DeltaGod/PER_MEA_LYINCROYAP/docs/gps_explication.pdf

# Module GPS u-blox NEO-6M

## Fonctionnement, diagnostic et correction

Projet Drone à voile

### LilyGO T-Beam V1.1 — ESP32 — Antenne Taoglas ADFGP.25A

Auteur Facundo Arito

Date 20 mai 2026

Fichier source main/src/drivers/GpsUart.cpp

Document généré automatiquement — usage interne

Drone à voile — Module GPS | Documentation technique

## 0 Contents

1 Vue d’ensemble du système GPS | 3
2 Le protocole UBX | 3
3 Pourquoi le GPS ne fonctionnait pas | 4
4 Les deux commandes UBX de correction | 5
5 Explication ligne par ligne de GpsUart::begin() | 9
6 Fonctionnement de GpsUart::update() | 12
7 Guide de diagnostic | 14

8 Chronologie de l’initialisation | 15
Conclusion | 15

## 1 Vue d’ensemble du système GPS

### 1.1 Rôle du GPS dans le drone

Le module GPS fournit au drone sa position géographique (latitude, longitude), sa vitesse sur l’eau et son cap. Ces données sont essentielles pour le pilotage automatique et pour le journal de navigation.

### 1.2 Composants matériels

Matériel impliqué

Composant | Rôle
LilyGO T-Beam V1.1 | Carte principale — intègre un ESP32, un module
| u-blox NEO-6M et un connecteur u.FL pour antenne
| externe
u-blox NEO-6M | Récepteur GPS. Communique avec l’ESP32 via UART (Serial1) et accepte des commandes de
| configuration binaires (protocole UBX)
Taoglas ADFGP.25A | Antenne active externe (patch céramique + LNA
| intégré). Le LNA nécessite une tension DC transmise
| sur le câble coaxial
Câble u.FL vers SMA | Connecte le NEO-6M à l’antenne externe

### 1.3 Flux de données

Antenne | −→ | NEO-6M | −→ | ESP32
Signal RF 1575 MHz | | Décode les satellites | | Phrases NMEA (ASCII)

Le NEO-6M reçoit les signaux radio des satellites, calcule la position et émet des phrases NMEA sur son UART. L’ESP32 lit ce flux via Serial1 et utilise la biblio-thèque TinyGPSPlus pour en extraire les données utiles.

## 2 Le protocole UBX

### 2.1 Deux langages sur un même fil

Le NEO-6M supporte deux protocoles sur son UART :

- NMEA — phrases textuelles (ex. $GPGGA,...) lues pour extraire la position. C’est le flux normal en fonctionnement.
- UBX — protocole binaire propriétaire u-blox, utilisé pour configurer le module (activer des fonctions, modifier des paramètres, sauvegarder en mémoire).

Le NEO-6M distingue une trame UBX d’une phrase NMEA grâce aux deux premiers octets : 0xB5 62 pour UBX, le caractère $ pour NMEA.

### 2.2 Structure d’une trame UBX

Sync 1 | Sync 2 | Classe | ID | Longueur
(LE)

Payload

0xB5 | 0x62 | 1 octet | 1 octet | 2 octets | N octets

Chaque trame se termine par un checksum de Fletcher sur 2 octets (CK_A, CK_B), calculé sur tous les octets depuis la classe jusqu’à la fin du payload (les deux octets de synchronisation sont exclus).

### 2.3 Calcul du checksum de Fletcher

1 | u i nt8_t CK_ A = 0 , CK_B = 0;
2 | // Parcourir : classe + ID + longueur (2 octets) + payload
3 | f o r ( i nt i = 0; i < N ; i ++) {
4 | CK_ A += d a t a [ i ];
5 | CK_B += CK_ A ;
6 | }
7 | // CK_ A et CK_B sont appended a la fin de la trame

Ce checksum garantit l’intégrité de la trame : si un bit est corrompu, le NEO-6M ignore la commande.

## 3 Pourquoi le GPS ne fonctionnait pas

### 3.1 Symptôme observé

Le compteur chars de TinyGPSPlus restait figé à 10 malgré le GPS alimenté et l’antenne connectée.

Diagnostic : que signifie chars = 10 ?

chars comptabilise chaque octet reçu sur Serial1. Une trame UBX ACK-ACK (réponse d’acquittement du NEO-6M) fait exactement 10 octets :

B5 62 05 01 02 00 06 09 17 6B
B5 62 Sync UBX
05 01 Classe ACK, ID ACK
02 00 Longueur payload = 2
06 09 Écho de la commande acquittée (classe CFG, ID CFG)

17 6B Checksum

Conclusion : le GPS était bien alimenté et fonctionnel, il répondait aux commandes UBX, mais n’émettait aucune phrase NMEA.

### 3.2 Cause racine : la mémoire flash interne du NEO-6M

Le NEO-6M possède une mémoire flash interne qui persiste la configuration entre les mises sous tension. Une session de configuration antérieure (via le logiciel u-center de u-blox) avait sauvegardé une configuration qui désactivait toutes les phrases NMEA.

Cause identifiée

La configuration persistante en flash désactivait la sortie NMEA sur le port UART du NEO-6M. Le module fonctionnait normalement mais n’émettait que des réponses UBX, invisibles pour TinyGPSPlus.

### 3.3 Cause aggravante : antenne active sans alimentation DC

L’antenne Taoglas ADFGP.25A est une antenne active : elle contient un amplificateur LNA qui nécessite une tension DC transmise sur le câble coaxial. Par défaut après une réinitialisation ROM, le superviseur d’antenne du NEO-6M est désactivé :

- Aucune tension DC sur le connecteur u.FL ⇒ LNA hors tension.
- Le commutateur RF du T-Beam pointe vers le patch céramique interne au lieu de l’antenne externe.
- Résultat : zéro signal GPS même avec l’antenne externe branchée.

## 4 Les deux commandes UBX de correction

### 4.1 Commande 1 — CFG-CFG : réinitialisation usine

### 4.1.1 Objectif

Effacer la configuration sauvegardée en flash et recharger les paramètres d’usine depuis la ROM interne. Après cette commande :

- Le UART1 du NEO-6M repasse à 9 600 bauds.
- Toutes les phrases NMEA standard sont réactivées.
- Le superviseur d’antenne est désactivé (état ROM par défaut).

### 4.1.2 Structure de la trame

Sync | Classe | ID | Longueur | Payload | CRC
0xB5 62 | 0x06 | 0x09 | 0x0D 00 | 13 octets | 0x71 FE

Classe 0x06 = CFG (configuration), ID 0x09 = sous-commande de gestion de la configuration persistante.

### 4.1.3 Décomposition du payload (13 octets, little-endian)

Champ (32 bits
LE)
Valeur hex | Signification
clearMask | 0x0000001F | Efface 5 sections de configuration
saveMask | 0x00000000 | Ne sauvegarde rien
loadMask | 0x0000001F | Recharge depuis la ROM
deviceMask | 0x17 (8 bits) | Cible : BBR + Flash + EEPROM

Pourquoi clearMask

Ce champ est un masque de bits : chaque bit correspond à une section de la configuration persistante.

Bit | Valeur hex | Section effacée
0 | 0x01 | ioPort — configuration des ports (UART,
| | SPI, USB)
1 | 0x02 | msgConf — activation des phrases
| | NMEA/UBX par port
2 | 0x04 | infMsg — messages d’information
3 | 0x08 | navConf — paramètres de navigation (mode,
| | SBAS)
4 | 0x10 | rxmConf — mode récepteur
0x01 | 0x02 | 0x04 | 0x08 | 0x10 = 0x1F

La section msgConf (bit 1) est la plus critique : c’est elle qui désactivait les phrases NMEA dans notre cas.

### 4.1.4 Code source et explication octet par octet

1 | st a t i c c o nst u i nt8_t kCfgCfgR e s e t [] = {
2 | 0 xB5 , 0 x62 , | // Sync UBX -- debut obligato

ire de toute trame

3 | 0 x06 , 0 x09 , | // Classe CFG (0 x06 ), ID CFG

(0 x09 )

4 | 0 x0D , 0 x00 , | // Longueur payload : 13 octe

ts (littl e-endian)

5 | 0 x1F , 0 x00 , 0 x00 , 0 x00 , // clearMask : efface 5 sectio

ns de config

6 | 0 x00 , 0 x00 , 0 x00 , 0 x00 , // saveMask | : ne sauvegarde r

ien

7 | 0 x1F , 0 x00 , 0 x00 , 0 x00 , // loadMask | : recharge depuis

la ROM

8 | 0 x17 , | // deviceMask : BBR (1) +Flash
(2) +EEPROM(4)+SPI (16)
9 | 0 x71 , 0 xF E | // Checks um Fletch er (CK_ A=0

x71 , CK_B =0 xFE)

10 };

Pourquoi static const ?

static dans une fonction signifie que le tableau est alloué une seule fois en mémoire flash (section .rodata), et non sur la pile à chaque appel. Sur un microcontrôleur avec peu de RAM comme l’ESP32, c’est une bonne pratique pour les constantes volumineuses.

### 4.2 Commande 2 — CFG-ANT : activation de l’antenne active

### 4.2.1 Objectif

Activer le superviseur d’antenne du NEO-6M, qui accomplit trois actions :

1. Fournit une tension DC sur le câble coaxial pour alimenter le LNA de l’antenne Taoglas.
2. Commande le commutateur RF du T-Beam (via la broche ANT_FLAG du NEO-6M) pour sélectionner l’antenne externe u.FL.
3. Active la détection de court-circuit pour protéger le module.

### 4.2.2 Structure de la trame

Sync | Classe | ID | Longueur | Payload | CRC
0xB5 62 | 0x06 | 0x13 | 0x04 00 | 4 octets | 0x47
| | | | | 57

Classe 0x06 = CFG, ID 0x13 = ANT (configuration de l’antenne).

### 4.2.3 Décomposition du payload

Champ
(16 bits)
Valeur | Signification
flags | 0x001B | Voir tableau ci-dessous
pins | 0x000F | Mapping broches — valeur par défaut
| | NEO-6M

Décomposition de flags = 0x001B

Bit | Nom | Fonction
0 | svcs | Alimentation DC + commutateur RF vers
| | antenne externe
1 | scd | Détection de court-circuit
3 | pdwnOnSCD | Coupe l’alimentation si court-circuit détecté
4 | recovery | Rétablissement automatique après court-circuit
0x01 | 0x02 | 0x08 | 0x10 = 0x1B

### 4.2.4 Code source

1 | st a t i c c o nst u i nt8_t kCfg A nt [] = {
2 | 0 xB5 , 0 x62 , | // Sync UBX
3 | 0 x06 , 0 x13 , | // Classe CFG (0 x06 ), ID ANT (0 x13 )
4 | 0 x04 , 0 x00 , | // Longueur payload : 4 octets
5 | 0 x1B , 0 x00 , | // flags (LE) : svcs + scd + pdwn O nSCD +

recovery

6 | 0 x0F , 0 x00 , | // pins | (LE) : mapping broches par defa
| ut NEO -6M
7 | 0 x47 , 0 x57 | // Checks um Fletch er
8 | };

## 5 Explication ligne par ligne de GpsUart::begin()

Voici le code complet de la fonction, suivi d’une explication détaillée de chaque bloc.

1 | v o i d Gps U a rt :: b e g i n () {
2 | gsvT o t a l_ . b e g i n ( gps_ , " GPGSV ", 3) ;
3 | S e r i a l1 . b e g i n ( B o a rdC o nf i g :: GPS_B A U D_R A T E , S E R I A L_8N1 ,
4 | B o a rdC o nf i g :: GPS_RX_P IN , B o a rdC o nf i g ::
| GPS_TX_P I N ) ;
5 | DBG ("GPS", "Serial1 started %u baud RX=GPIO%d TX=GPIO%
| d",
6 | ( u ns i gn e d ) B o a rdC o nf i g :: GPS_B A U D_R A T E ,
7 | B o a rdC o nf i g :: GPS_RX_P IN , B o a rdC o nf i g :: GPS_TX_P I N ) ;

8

9 | d e l a y (500) ; | // attendr e fin du boot interne du NEO -6

M

10
11 | st a t i c c o nst u i nt8_t kCfgCfgR e s e t [] = {
12 | 0 xB5 , 0 x62 , 0 x06 , 0 x09 , 0 x0D , 0 x00 ,
13 | 0 x1F , 0 x00 , 0 x00 , 0 x00 ,
14 | 0 x00 , 0 x00 , 0 x00 , 0 x00 ,
15 | 0 x1F , 0 x00 , 0 x00 , 0 x00 ,
16 | 0 x17 ,
17 | 0 x71 , 0 xF E
18 | };
19 | S e r i a l1 . wr i t e ( kCfgCfgR e s et , s i z e o f ( kCfgCfgR e s e t ) ) ;
20 | DBG ("GPS", "CFG -CFG sent -- factory reset to ROM defau
| lts ") ;
21 | d e l a y (1500) ; | // attendr e redemarrage apres reinitiali
| sation

22
23 | wh i l e ( S e r i a l1 . a v a i l a bl e () ) S e r i a l1 . r e a d () ; | // vider
| le buffer

24
25 | st a t i c c o nst u i nt8_t kCfg A nt [] = {
26 | 0 xB5 , 0 x62 , 0 x06 , 0 x13 , 0 x04 , 0 x00 ,
27 | 0 x1B , 0 x00 ,
28 | 0 x0F , 0 x00 ,
29 | 0 x47 , 0 x57
30 | };
31 | S e r i a l1 . wr i t e ( kCfg A nt , s i z e o f ( kCfg A nt ) ) ;
32 | d e l a y (100) ;
33 | DBG ("GPS", "CFG -ANT sent -- active antenna supervisor
| + bias enabled") ;
34 | }

### 5.1 Bloc 1 — Initialisation du parser NMEA personnalisé

1 gsvT o t a l_ . b e g i n ( gps_ , " GPGSV ", 3) ;

TinyGPSPlus ne décode pas toutes les phrases NMEA automatiquement. La phrase GPGSV (satellites en vue) n’est pas traitée par défaut : il faut déclarer explicitement quel champ extraire.

gsvTotal_ est un objet TinyGPSCustom. Cette ligne lui dit : dans les phrases GPGSV, extraire le champ numéro 3 (le nombre total de satellites en vue). Ce champ devient

lisible via gsvTotal_.value().

### 5.2 Bloc 2 — Ouverture du port série

1 | S e r i a l1 . b e g i n ( B o a rdC o nf i g :: GPS_B A U D_R A T E , S E R I A L_8N1 ,
2 | B o a rdC o nf i g :: GPS_RX_P IN , B o a rdC o nf i g :: GPS_TX_P I N ) ;

Configure le port UART1 de l’ESP32 pour communiquer avec le NEO-6M :

- GPS_BAUD_RATE = 9 600 bauds — vitesse par défaut ROM du NEO-6M.
- SERIAL_8N1 — 8 bits de données, pas de parité, 1 bit de stop.
- Les broches GPIO sont définies dans BoardConfig.h et correspondent au câblage du T-Beam.

### 5.3 Bloc 3 — Attente de démarrage du GPS

1 d e l a y (500) ;

Le NEO-6M a besoin d’environ 100 à 400 ms pour terminer sa séquence de mise sous tension. Sans ce délai, les commandes UBX envoyées immédiatement pourraient être ignorées. On attend 500 ms pour une marge confortable.

### 5.4 Bloc 4 — Envoi de CFG-CFG

1 S e r i a l1 . wr i t e ( kCfgCfgR e s et , s i z e o f ( kCfgCfgR e s e t ) ) ;

Envoie les 21 octets de la trame CFG-CFG sur le UART. sizeof() est évalué par le compilateur : sa valeur est exacte et ne peut pas être oubliée ou erronée.

Le NEO-6M reçoit la trame, vérifie le checksum, puis :

1. Efface les sections spécifiées en flash et BBR.
2. Recharge ces sections depuis sa ROM (paramètres d’usine).
3. Envoie une trame ACK-ACK de confirmation.

4. Redémarre son moteur de navigation interne.

### 5.5 Bloc 5 — Attente du redémarrage

1 d e l a y (1500) ;

La réinitialisation ROM prend entre 500 ms et 1 200 ms. On attend 1 500 ms pour s’assurer que le module est de nouveau prêt avant d’envoyer CFG-ANT.

### 5.6 Bloc 6 — Vidage du buffer

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

Pendant le délai de 1 500 ms, le GPS a pu envoyer des données sur le UART (ACK-ACK, premières phrases NMEA de démarrage). Ces données s’accumulent dans le buffer de l’ESP32. On les lit et on les jette pour repartir sur une base propre avant CFG-ANT.

### 5.7 Bloc 7 — Envoi de CFG-ANT

1 | S e r i a l1 . wr i t e ( kCfg A nt , s i z e o f ( kCfg A nt ) ) ;
2 | d e l a y (100) ;

Envoie les 12 octets de la trame CFG-ANT. Le NEO-6M l’applique immédiatement :

1. Alimentation DC activée sur u.FL ⇒ LNA Taoglas alimenté.
2. Commutateur RF du T-Beam basculé vers l’antenne externe.
3. Détection de court-circuit activée.

Le delay(100) laisse le temps au module d’appliquer la configuration et de renvoyer l’ACK avant la fin de la fonction.

## 6 Fonctionnement de GpsUart::update()

La fonction update() est appelée à chaque cycle de la boucle principale (environ 50 fois par seconde). Elle lit les octets disponibles sur le UART et les passe au parser

TinyGPSPlus.

1 | v o i d Gps U a rt :: u pd a t e () {
2 | wh i l e ( S e r i a l1 . a v a i l a bl e () ) {
3 | ch a r c = S e r i a l1 . r e a d () ;
4 | gps_ . e nc o d e ( c ) ; | // (1) passe l’octet
| au parser

5
6 | i f ( c == ’\n’) { | // (2) fin de phr ase

NMEA

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

;

9 | l i n e L e n_ = 0;
10 | } e ls e i f ( c != ’\r’ && l i n e L e n_ < s i z e o f ( l i n e B u f_
) - 1) {
11 | l i n e B u f_ [ l i n e L e n_ ++] = c ; // (3) açumule les c
| aracteres
12 | }
13 | }

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

16
17 | i f ( n o wV a l i d && ! pr e vV a l i d_ ) { DBG (" GPS", "FIX ACQUIRE
| D ...") ; }
18 | i f (! n o wV a l i d && pr e vV a l i d_ ) { DBG (" GPS", "FIX LOST") ;
}
19 | pr e vV a l i d_ = n o wV a l i d ;

20
21 | p o s_ . v a l i d | = n o wV a l i d ; | // (5) mise a jour

str ucture publique

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

0.0;

23 | p o s_ . l o n | = n o wV a l i d ? gps_ . l o c a t i o n . lng () | :

0.0;

24 | p o s_ . sp e e dKmph | = gps_ . sp e e d . i sV a l i d ()
25 | ? ( fl o a t ) gps_ . sp e e d . kmph () | : 0.0 f

;

26 | p o s_ . c o u rs e D e g | = gps_ . c o u rs e . i sV a l i d ()
27 | ? ( fl o a t ) gps_ . c o u rs e . d e g () | : 0.0 f

;

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

: 0;

30 | p o s_ . hd o p | = gps_ . hd o p . i sV a l i d ()
31 | ? ( fl o a t ) gps_ . hd o p . hd o p () | : 99.9

f ;

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

U L ;

34 }

1. gps_.encode(c) — Le cœur du parser. TinyGPSPlus reçoit un octet à la fois et reconstruit les phrases NMEA en interne. Quand une phrase complète et valide est reçue, il met à jour ses champs internes (location, speed, satellites, etc.).
2. Capture de la phrase complète — Quand le caractère \n (fin de ligne NMEA) est reçu, on copie le buffer dans completedLine_ pour permettre l’affichage de la dernière phrase NMEA lors du diagnostic.
3. Accumulation caractère par caractère — Les caractères sont accumulés dans lineBuf_. Le \r (retour chariot) est ignoré : le protocole NMEA utilise CR+LF comme fin de ligne, mais seul LF délimite la phrase.
4. gps_.location.isValid() — Retourne true uniquement si une phrase NMEA valide avec fix actif a été reçue récemment. Un fix froid (premier démarrage) prend typiquement 30 secondes à 2 minutes à l’extérieur avec une bonne vue du ciel.
5. Mise à jour de pos_ — La structure publique est rafraîchie à chaque appel. Un champ invalide retourne une valeur de sécurité : 0.0 pour les coordonnées, 99.9 pour HDOP (valeur maximale = pas de fix), 0xFFFFFFFF pour l’âge (signifiant donnée absente).

## 7 Guide de diagnostic

Symptôme | Cause probable | Action
chars figé à 0 | UART mal câblé, broches TX/RX échangées, ou GPS non alimenté | Vérifier câblage et alimentation

Symptôme | Cause probable | Action
chars figé à 10 | Config flash corrompue — NMEA désactivé | Déjà corrigé dans begin() par CFG-CFG
chars monte, visible = 0 | Obstruction physique (toit, bâtiment) | Aller à l’extérieur, ciel dégagé
chars monte, visible > 0, pas de fix | Temps d’acquisition froid normal | Attendre 1 à 3 min à l’extérieur
chars monte, visible = 0 même dehors | LNA non alimenté ou mauvais connecteur | Vérifier CFG-ANT, câble u.FL et sertissage
Fix acquis puis perdu régulièrement | HDOP élevé, obstruction partielle | Dégager la vue du ciel (mât, pont)

## 8 Chronologie de l’initialisation

Temps (ms) Événement

0 | Serial1.begin() — UART ESP32 ouvert à 9 600 bauds
0 – 500 | Délai de démarrage — le NEO-6M termine son boot interne
500 | Envoi de CFG-CFG — demande de réinitialisation ROM
≈ 501 | Le NEO-6M répond ACK-ACK (10 octets)
501 – 2000 | Délai de redémarrage — rechargement de la config ROM
2000 | Vidage du buffer UART
2000 | Envoi de CFG-ANT — activation du superviseur d’antenne
≈ 2100 | Fin de begin() — le GPS est prêt à émettre du NMEA
2100+ | update() appelé en boucle — décodage des phrases NMEA
≈ 60 000 – 180 000 | Premier fix GPS (typique en extérieur, ciel dégagé)

## 8 Conclusion

Le dysfonctionnement du GPS était dû à la persistance d’une configuration corrompue dans la mémoire flash interne du NEO-6M, qui avait désactivé toutes les sorties NMEA. La correction consiste à envoyer systématiquement, à chaque démarrage, une commande de réinitialisation usine (CFG-CFG) suivie de l’activation du superviseur d’antenne active (CFG-ANT).

Ces deux commandes sont intégrées dans GpsUart::begin(), ce qui garantit un comportement correct indépendamment de toute session de configuration antérieure effectuée avec u-center ou tout autre outil.

État actuel du système

✓ Phrases NMEA réactivées systématiquement à chaque boot. ✓ Antenne active Taoglas ADFGP.25A alimentée correctement. ✓ Commutateur RF T-Beam basculé vers l’antenne externe. ✓ Fix GPS confirmé lors des tests en extérieur.
