DeltaGod/PER_MEA_LYINCROYAP/main/src/navigation/navigation.h

/**
 * Logique de navigation partagee entre le firmware Arduino et la simulation.
 */

#ifndef NAVIGATION_H
#define NAVIGATION_H

#include <cmath>

#ifndef M_PI
#define M_PI 3.14159265358979323846
#endif

static const double NAV_DIRECT_DEAD_ZONE_DEG = 5.0;
static const double NAV_VDB_RUDDER_GAIN = 0.8;
static const double NAV_DIRECT_RUDDER_GAIN = 0.5;
static const float NAV_RUDDER_CORRECTION_LIMIT_DEG = 20.0f;
static const float NAV_RUDDER_COMMAND_LIMIT_DEG = 110.0f;
static const double NAV_DEFAULT_CORRIDOR_HALF_WIDTH_M = 100.0;
static const double NAV_GEO_EPSILON_DEG = 0.0000001;
static const double NAV_EARTH_RADIUS_M = 6371000.0;
static const double NAV_UPWIND_FORBIDDEN_ANGLE_DEG = 45.0;
static const double NAV_DOWNWIND_FORBIDDEN_ANGLE_DEG = 20.0;
static const double NAV_RUDDER_STEP_DEG = 5.0;
static const double NAV_SAIL_RIGHT_DEG = 10.0;
static const double NAV_SAIL_LEFT_DEG = -10.0;

inline double nav_relativeAngle(double referenceDeg, double targetDeg) {
  double relativeDeg = targetDeg - referenceDeg;
  if (relativeDeg > 180)
    relativeDeg -= 360;
  else if (relativeDeg < -180)
    relativeDeg += 360;
  return relativeDeg;
}

inline bool nav_sameSign(double a, double b) {
  return (a >= 0 && b >= 0) || (a < 0 && b < 0);
}

inline double nav_oppositeAngle(double angleDeg) {
  double oppositeDeg = angleDeg + 180;
  return (oppositeDeg >= 360) ? oppositeDeg - 360 : oppositeDeg;
}

inline int nav_angleSide(double angleDeg) { return angleDeg < 0 ? -1 : 1; }

inline float nav_clampRudder(float rudderAngleDeg) {
  if (rudderAngleDeg > NAV_RUDDER_CORRECTION_LIMIT_DEG)
    return NAV_RUDDER_CORRECTION_LIMIT_DEG;
  if (rudderAngleDeg < -NAV_RUDDER_CORRECTION_LIMIT_DEG)
    return -NAV_RUDDER_CORRECTION_LIMIT_DEG;
  return rudderAngleDeg;
}

inline float nav_rudderCompensation(double relativeWindDeg) {
  return static_cast<float>(relativeWindDeg / 2.0);
}

inline float nav_rudderCorrection(float servoCommandDeg,
                                  double relativeWindDeg) {
  return nav_clampRudder(servoCommandDeg -
                         nav_rudderCompensation(relativeWindDeg));
}

inline float nav_rudderCommand(float correctionDeg, double relativeWindDeg) {
  float commandDeg =
      nav_rudderCompensation(relativeWindDeg) + nav_clampRudder(correctionDeg);
  if (commandDeg > NAV_RUDDER_COMMAND_LIMIT_DEG)
    return NAV_RUDDER_COMMAND_LIMIT_DEG;
  if (commandDeg < -NAV_RUDDER_COMMAND_LIMIT_DEG)
    return -NAV_RUDDER_COMMAND_LIMIT_DEG;
  return commandDeg;
}

inline double nav_normalizeAngle(double angleDeg) {
  while (angleDeg >= 360)
    angleDeg -= 360;
  while (angleDeg < 0)
    angleDeg += 360;
  return angleDeg;
}

inline bool nav_isBetweenOnShortestTurn(double angleDeg, double startDeg,
                                        double endDeg) {
  double turnDeg = nav_relativeAngle(startDeg, endDeg);
  double angleFromStartDeg = nav_relativeAngle(startDeg, angleDeg);
  if (turnDeg >= 0)
    return angleFromStartDeg > 0 && angleFromStartDeg < turnDeg;
  return angleFromStartDeg < 0 && angleFromStartDeg > turnDeg;
}

inline void nav_gpsDeltaMeters(double refLatDeg, double refLngDeg,
                               double latDeg, double lngDeg, double &eastM,
                               double &northM) {
  double latRad = refLatDeg * M_PI / 180.0;
  northM = (latDeg - refLatDeg) * NAV_EARTH_RADIUS_M * M_PI / 180.0;
  eastM = (lngDeg - refLngDeg) * NAV_EARTH_RADIUS_M * std::cos(latRad) * M_PI /
          180.0;
}

inline double nav_crossTrackErrorMeters(double startLatDeg, double startLngDeg,
                                        double endLatDeg, double endLngDeg,
                                        double boatLatDeg, double boatLngDeg) {
  double pathEastM, pathNorthM, boatEastM, boatNorthM;
  nav_gpsDeltaMeters(startLatDeg, startLngDeg, endLatDeg, endLngDeg, pathEastM,
                     pathNorthM);
  nav_gpsDeltaMeters(startLatDeg, startLngDeg, boatLatDeg, boatLngDeg,
                     boatEastM, boatNorthM);

  double pathLengthM =
      std::sqrt(pathEastM * pathEastM + pathNorthM * pathNorthM);
  if (pathLengthM < 0.1)
    return 0.0;

  return (pathNorthM * boatEastM - pathEastM * boatNorthM) / pathLengthM;
}

inline bool nav_hasPassedWaypoint(double startLatDeg, double startLngDeg,
                                  double endLatDeg, double endLngDeg,
                                  double boatLatDeg, double boatLngDeg) {
  double pathEastM, pathNorthM, boatEastM, boatNorthM;
  nav_gpsDeltaMeters(startLatDeg, startLngDeg, endLatDeg, endLngDeg, pathEastM,
                     pathNorthM);
  nav_gpsDeltaMeters(startLatDeg, startLngDeg, boatLatDeg, boatLngDeg,
                     boatEastM, boatNorthM);

  double pathLengthSquared =
      pathEastM * pathEastM + pathNorthM * pathNorthM;
  if (pathLengthSquared < 0.01)
    return false;

  return boatEastM * pathEastM + boatNorthM * pathNorthM >=
         pathLengthSquared;
}

inline int nav_sideMovingTowardCrossTrack(double startLatDeg,
                                          double startLngDeg, double endLatDeg,
                                          double endLngDeg, double axisDeg,
                                          double safeAngleDeg,
                                          int desiredCrossTrackSign,
                                          int fallbackSide) {
  double pathEastM, pathNorthM;
  nav_gpsDeltaMeters(startLatDeg, startLngDeg, endLatDeg, endLngDeg, pathEastM,
                     pathNorthM);
  double pathLengthM =
      std::sqrt(pathEastM * pathEastM + pathNorthM * pathNorthM);
  if (pathLengthM < 0.1)
    return fallbackSide;

  double pathEastUnit = pathEastM / pathLengthM;
  double pathNorthUnit = pathNorthM / pathLengthM;
  int bestSide = fallbackSide;
  double bestScore = -1.0;

  for (int side = -1; side <= 1; side += 2) {
    double headingRad = nav_normalizeAngle(axisDeg + side * safeAngleDeg) *
                        M_PI / 180.0;
    double crossVelocity =
        pathNorthUnit * std::sin(headingRad) -
        pathEastUnit * std::cos(headingRad);

    if ((desiredCrossTrackSign > 0 && crossVelocity > 0) ||
        (desiredCrossTrackSign < 0 && crossVelocity < 0)) {
      double score = std::abs(crossVelocity);
      if (score > bestScore) {
        bestScore = score;
        bestSide = side;
      }
    }
  }

  return bestSide;
}

inline int nav_sideMovingTowardWaypoint(double axisDeg, double safeAngleDeg,
                                        double waypointHeadingDeg,
                                        int fallbackSide) {
  int bestSide = fallbackSide;
  double bestProgress = -2.0;
  double waypointHeadingRad = waypointHeadingDeg * M_PI / 180.0;

  for (int side = -1; side <= 1; side += 2) {
    double headingRad = nav_normalizeAngle(axisDeg + side * safeAngleDeg) *
                        M_PI / 180.0;
    double progress =
        std::sin(headingRad) * std::sin(waypointHeadingRad) +
        std::cos(headingRad) * std::cos(waypointHeadingRad);
    if (progress > bestProgress) {
      bestProgress = progress;
      bestSide = side;
    }
  }

  return bestSide;
}

struct NavResult {
  float sailAngle;
  float rudderAngle;
  int sendInterval;
  const char *mode;
  const char *logMessage;
  bool windAcquired;
  double acquiredWindDir;
  bool waypointReached;
};

struct NavCorridor {
  bool initialized;
  double startLatDeg;
  double startLngDeg;
  double targetLatDeg;
  double targetLngDeg;
};

enum NavEmpannagePhase {
  NAV_EMPANNAGE_AUCUN = 0,
  NAV_EMPANNAGE_ALLER_LIMITE_UPWIND,
  NAV_EMPANNAGE_CROISER_AXE_UPWIND,
  NAV_EMPANNAGE_REVENIR_LIMITE_DOWNWIND
};

struct NavState {
  NavCorridor corridor;
  int upwindSide;
  int downwindSide;
  NavEmpannagePhase empannagePhase;
  int empannageTargetSide;
};

inline void nav_resetCorridor(NavState &state) { state.corridor = {}; }

inline void nav_resetState(NavState &state) {
  nav_resetCorridor(state);
  state.upwindSide = 0;
  state.downwindSide = 0;
  state.empannagePhase = NAV_EMPANNAGE_AUCUN;
  state.empannageTargetSide = 0;
}

inline bool nav_hasCorridor(double boatLatDeg, double boatLngDeg,
                            double waypointLatDeg, double waypointLngDeg,
                            double halfWidthM) {
  return halfWidthM > 0.0 &&
         (std::abs(waypointLatDeg - boatLatDeg) > NAV_GEO_EPSILON_DEG ||
          std::abs(waypointLngDeg - boatLngDeg) > NAV_GEO_EPSILON_DEG);
}

inline void nav_updateCorridor(NavState &state, bool hasCorridor,
                               double boatLatDeg, double boatLngDeg,
                               double waypointLatDeg, double waypointLngDeg) {
  if (!hasCorridor) {
    nav_resetCorridor(state);
    return;
  }

  bool targetChanged =
      std::abs(waypointLatDeg - state.corridor.targetLatDeg) >
          NAV_GEO_EPSILON_DEG ||
      std::abs(waypointLngDeg - state.corridor.targetLngDeg) >
          NAV_GEO_EPSILON_DEG;
  if (state.corridor.initialized && !targetChanged)
    return;

  state.corridor = {true, boatLatDeg, boatLngDeg, waypointLatDeg,
                    waypointLngDeg};
  state.upwindSide = 0;
  state.downwindSide = 0;
  state.empannagePhase = NAV_EMPANNAGE_AUCUN;
  state.empannageTargetSide = 0;
}

inline void nav_applyTargetHeading(NavResult &result, double boatHeadingDeg,
                                   double targetHeadingDeg,
                                   double relativeWindDeg, double rudderGain,
                                   const char *mode, const char *logMessage,
                                   int sendInterval) {
  double headingErrorDeg = nav_relativeAngle(boatHeadingDeg, targetHeadingDeg);
  result.sailAngle =
      (relativeWindDeg < 0) ? NAV_SAIL_LEFT_DEG : NAV_SAIL_RIGHT_DEG;
  result.rudderAngle = nav_clampRudder(-headingErrorDeg * rudderGain);
  result.sendInterval = sendInterval;
  result.mode = mode;
  result.logMessage = logMessage;
}

inline int nav_corridorSide(const NavState &state, double boatLatDeg,
                            double boatLngDeg, double corridorHalfWidthM,
                            double axisDeg, double safeAngleDeg,
                            int currentSide) {
  if (!state.corridor.initialized)
    return currentSide;

  double crossTrackErrorM = nav_crossTrackErrorMeters(
      state.corridor.startLatDeg, state.corridor.startLngDeg,
      state.corridor.targetLatDeg, state.corridor.targetLngDeg, boatLatDeg,
      boatLngDeg);
  if (crossTrackErrorM > corridorHalfWidthM) {
    return nav_sideMovingTowardCrossTrack(
        state.corridor.startLatDeg, state.corridor.startLngDeg,
        state.corridor.targetLatDeg, state.corridor.targetLngDeg, axisDeg,
        safeAngleDeg, -1, currentSide);
  }
  if (crossTrackErrorM < -corridorHalfWidthM) {
    return nav_sideMovingTowardCrossTrack(
        state.corridor.startLatDeg, state.corridor.startLngDeg,
        state.corridor.targetLatDeg, state.corridor.targetLngDeg, axisDeg,
        safeAngleDeg, 1, currentSide);
  }
  return currentSide;
}

inline void nav_startAvoidEmpannage(NavResult &result, NavState &state,
                                    double boatHeadingDeg,
                                    double windDirectionDeg,
                                    double relativeWind, int targetSide,
                                    const char *logMessage) {
  state.empannageTargetSide = targetSide;
  state.empannagePhase = NAV_EMPANNAGE_ALLER_LIMITE_UPWIND;

  double targetHeading = nav_normalizeAngle(
      windDirectionDeg - state.downwindSide * NAV_UPWIND_FORBIDDEN_ANGLE_DEG);
  nav_applyTargetHeading(result, boatHeadingDeg, targetHeading, relativeWind,
                         NAV_DIRECT_RUDDER_GAIN, "avoid-gybe", logMessage, 300);
}

inline void nav_handleEmpannageLoop(NavResult &result, NavState &state,
                                    double boatHeadingDeg,
                                    double windDirectionDeg,
                                    double oppositeWind, double relativeWind) {
  double targetHeading;
  const char *mode = "avoid-gybe";
  const char *logMessage = "Avoid empannage: loop around through upwind";

  if (state.empannagePhase == NAV_EMPANNAGE_ALLER_LIMITE_UPWIND) {
    targetHeading = nav_normalizeAngle(
        windDirectionDeg - state.downwindSide * NAV_UPWIND_FORBIDDEN_ANGLE_DEG);
    if (std::abs(nav_relativeAngle(boatHeadingDeg, targetHeading)) < 10.0)
      state.empannagePhase = NAV_EMPANNAGE_CROISER_AXE_UPWIND;
  } else if (state.empannagePhase == NAV_EMPANNAGE_CROISER_AXE_UPWIND) {
    targetHeading = nav_normalizeAngle(
        windDirectionDeg + state.downwindSide * NAV_UPWIND_FORBIDDEN_ANGLE_DEG);
    mode = "vdb";
    logMessage = "VDB: downwind loop crosses upwind axis";
    if (nav_angleSide(nav_relativeAngle(windDirectionDeg, boatHeadingDeg)) ==
        state.downwindSide) {
      state.downwindSide = state.empannageTargetSide;
      state.empannagePhase = NAV_EMPANNAGE_REVENIR_LIMITE_DOWNWIND;
    }
  } else {
    targetHeading = nav_normalizeAngle(
        oppositeWind +
        state.empannageTargetSide * NAV_DOWNWIND_FORBIDDEN_ANGLE_DEG);
    if (nav_angleSide(nav_relativeAngle(oppositeWind, boatHeadingDeg)) ==
        state.empannageTargetSide) {
      state.downwindSide = state.empannageTargetSide;
      state.empannagePhase = NAV_EMPANNAGE_AUCUN;
    }
  }

  nav_applyTargetHeading(result, boatHeadingDeg, targetHeading, relativeWind,
                         NAV_DIRECT_RUDDER_GAIN, mode, logMessage, 300);
}

inline void nav_handleForbiddenZone(NavResult &result, NavState &state,
                                    double boatHeadingDeg, double boatLatDeg,
                                    double boatLngDeg, double windAxisDeg,
                                    double waypointHeadingDeg,
                                    double relativeWind, bool hasCorridor,
                                    double corridorHalfWidthM, bool upwind) {
  int &side = upwind ? state.upwindSide : state.downwindSide;
  double forbiddenAngle =
      upwind ? NAV_UPWIND_FORBIDDEN_ANGLE_DEG : NAV_DOWNWIND_FORBIDDEN_ANGLE_DEG;
  double gain = upwind ? NAV_VDB_RUDDER_GAIN : NAV_DIRECT_RUDDER_GAIN;
  const char *mode = upwind ? "upwind-zigzag" : "downwind-zigzag";
  const char *logMessage = upwind ? "Waypoint in upwind forbidden zone"
                                  : "Waypoint in downwind forbidden zone";
  int sendInterval = upwind ? 300 : 2000;

  if (side == 0) {
    int currentSide =
        nav_angleSide(nav_relativeAngle(windAxisDeg, boatHeadingDeg));
    side = nav_sideMovingTowardWaypoint(
        windAxisDeg, forbiddenAngle, waypointHeadingDeg, currentSide);
  }
  if (hasCorridor) {
    side = nav_corridorSide(state, boatLatDeg, boatLngDeg, corridorHalfWidthM,
                            windAxisDeg, forbiddenAngle, side);
  }

  double targetHeading = nav_normalizeAngle(windAxisDeg + side * forbiddenAngle);
  nav_applyTargetHeading(result, boatHeadingDeg, targetHeading, relativeWind,
                         gain, mode, logMessage, sendInterval);
}

inline void nav_handleDownwindZigzag(NavResult &result, NavState &state,
                                     double boatHeadingDeg, double boatLatDeg,
                                     double boatLngDeg, double windDirectionDeg,
                                     double oppositeWind,
                                     double waypointHeadingDeg,
                                     double relativeWind, bool hasCorridor,
                                     double corridorHalfWidthM) {
  if (state.downwindSide == 0) {
    state.downwindSide =
        nav_angleSide(nav_relativeAngle(oppositeWind, boatHeadingDeg));
  }

  int desiredSide = state.downwindSide;
  if (hasCorridor) {
    desiredSide = nav_corridorSide(state, boatLatDeg, boatLngDeg,
                                   corridorHalfWidthM, oppositeWind,
                                   NAV_DOWNWIND_FORBIDDEN_ANGLE_DEG,
                                   state.downwindSide);
  }
  if (desiredSide != state.downwindSide) {
    nav_startAvoidEmpannage(result, state, boatHeadingDeg, windDirectionDeg,
                            relativeWind, desiredSide,
                            "Avoid empannage: loop around through upwind");
    return;
  }

  nav_handleForbiddenZone(result, state, boatHeadingDeg, boatLatDeg, boatLngDeg,
                          oppositeWind, waypointHeadingDeg, relativeWind, false,
                          corridorHalfWidthM, false);
}

inline void nav_handleLoferAbattre(NavResult &result, double relativeWind,
                                   float currentRudderAngle, bool lofer) {
  bool windLeft = relativeWind < 0;
  result.sailAngle = windLeft ? NAV_SAIL_LEFT_DEG : NAV_SAIL_RIGHT_DEG;
  result.rudderAngle =
      currentRudderAngle +
      (windLeft == lofer ? NAV_RUDDER_STEP_DEG : -NAV_RUDDER_STEP_DEG);
  result.mode = lofer ? "lofer" : "abattre";
  result.logMessage =
      lofer ? (windLeft ? "Lofer relativeWind < 0" : "Lofer relativeWind > 0")
            : (windLeft ? "Abattre relativeWind < 0"
                        : "Abattre relativeWind > 0");
}

inline NavResult
nav_handleWindObservation(double /* boatLat */, double /* boatLng */,
                          double /* startWptLat */, double /* startWptLng */,
                          double smoothHeadingDeg, double distanceFromStartM,
                          double requiredWindDistanceM, float currentSailAngle,
                          float currentRudderAngle) {
  NavResult result = {};
  result.sailAngle = currentSailAngle;
  result.rudderAngle = currentRudderAngle;
  result.sendInterval = 1000;
  result.mode = "wind-observation";

  if (distanceFromStartM >= requiredWindDistanceM) {
    result.windAcquired = true;
    result.acquiredWindDir = fmod(smoothHeadingDeg + 90.0 + 360.0, 360.0);
    result.logMessage = "wind acquired";
  }

  return result;
}

inline NavResult nav_handleNavigationWithState(
    NavState &state, double boatHeadingDeg, double waypointHeadingDeg,
    double waypointDistanceM, double windDirectionDeg, float currentSailAngle,
    float currentRudderAngle, double waypointReachedDistanceM,
    double boatLatDeg = 0.0, double boatLngDeg = 0.0,
    double waypointLatDeg = 0.0, double waypointLngDeg = 0.0,
    double corridorHalfWidthM = 0.0) {
  NavResult result = {};
  result.sailAngle = currentSailAngle;
  result.rudderAngle = currentRudderAngle;
  result.sendInterval = 2000;
  result.mode = "direct";
  if (waypointDistanceM <= waypointReachedDistanceM) {
    result.waypointReached = true;
    nav_resetState(state);
    return result;
  }

  bool hasCorridor = nav_hasCorridor(boatLatDeg, boatLngDeg, waypointLatDeg,
                                     waypointLngDeg, corridorHalfWidthM);
  nav_updateCorridor(state, hasCorridor, boatLatDeg, boatLngDeg, waypointLatDeg,
                     waypointLngDeg);
  if (state.corridor.initialized &&
      nav_hasPassedWaypoint(
          state.corridor.startLatDeg, state.corridor.startLngDeg,
          state.corridor.targetLatDeg, state.corridor.targetLngDeg, boatLatDeg,
          boatLngDeg) &&
      std::abs(nav_crossTrackErrorMeters(
          state.corridor.startLatDeg, state.corridor.startLngDeg,
          state.corridor.targetLatDeg, state.corridor.targetLngDeg, boatLatDeg,
          boatLngDeg)) <= corridorHalfWidthM) {
    result.waypointReached = true;
    nav_resetState(state);
    return result;
  }

  double oppositeWind = nav_oppositeAngle(windDirectionDeg);
  double relativeWind = nav_relativeAngle(boatHeadingDeg, windDirectionDeg);
  double relativeWpt = nav_relativeAngle(boatHeadingDeg, waypointHeadingDeg);
  float currentRudderCorrection =
      nav_rudderCorrection(currentRudderAngle, relativeWind);
  bool waypointUpwind =
      std::abs(nav_relativeAngle(windDirectionDeg, waypointHeadingDeg)) <
      NAV_UPWIND_FORBIDDEN_ANGLE_DEG;
  bool waypointDownwind =
      std::abs(nav_relativeAngle(oppositeWind, waypointHeadingDeg)) <
      NAV_DOWNWIND_FORBIDDEN_ANGLE_DEG;
  bool directCrossesUpwind = nav_isBetweenOnShortestTurn(
      windDirectionDeg, boatHeadingDeg, waypointHeadingDeg);
  bool directCrossesDownwind = nav_isBetweenOnShortestTurn(
      oppositeWind, boatHeadingDeg, waypointHeadingDeg);

  if (state.empannagePhase != NAV_EMPANNAGE_AUCUN) {
    nav_handleEmpannageLoop(result, state, boatHeadingDeg, windDirectionDeg,
                             oppositeWind, relativeWind);
  } else if (waypointUpwind || directCrossesUpwind) {
    nav_handleForbiddenZone(result, state, boatHeadingDeg, boatLatDeg,
                            boatLngDeg, windDirectionDeg, waypointHeadingDeg,
                            relativeWind, hasCorridor, corridorHalfWidthM, true);
  } else if (waypointDownwind) {
    nav_handleDownwindZigzag(result, state, boatHeadingDeg, boatLatDeg,
                             boatLngDeg, windDirectionDeg, oppositeWind,
                             waypointHeadingDeg, relativeWind, hasCorridor,
                             corridorHalfWidthM);
  } else if (directCrossesDownwind) {
    if (state.downwindSide == 0) {
      state.downwindSide =
          nav_angleSide(nav_relativeAngle(oppositeWind, boatHeadingDeg));
    }
    nav_startAvoidEmpannage(result, state, boatHeadingDeg, windDirectionDeg,
                            relativeWind, -state.downwindSide,
                            "Avoid empannage: direct path crosses downwind axis");
  } else if (std::abs(relativeWpt) <= NAV_DIRECT_DEAD_ZONE_DEG) {
    result.sailAngle =
        relativeWind < 0 ? NAV_SAIL_LEFT_DEG : NAV_SAIL_RIGHT_DEG;
    result.rudderAngle = 0;
    result.logMessage = "Direct: waypoint aligned";
  } else {
    nav_handleLoferAbattre(result, relativeWind, currentRudderCorrection,
                           nav_sameSign(relativeWind, relativeWpt));
  }

  result.rudderAngle = nav_rudderCommand(result.rudderAngle, relativeWind);
  return result;
}

inline NavResult nav_handleNavigation(
    double boatHeadingDeg, double waypointHeadingDeg, double waypointDistanceM,
    double windDirectionDeg, float currentSailAngle, float currentRudderAngle,
    double waypointReachedDistanceM, double boatLatDeg = 0.0,
    double boatLngDeg = 0.0, double waypointLatDeg = 0.0,
    double waypointLngDeg = 0.0, double corridorHalfWidthM = 0.0) {
  static NavState state = {};
  return nav_handleNavigationWithState(
      state, boatHeadingDeg, waypointHeadingDeg, waypointDistanceM,
      windDirectionDeg, currentSailAngle, currentRudderAngle,
      waypointReachedDistanceM, boatLatDeg, boatLngDeg, waypointLatDeg,
      waypointLngDeg, corridorHalfWidthM);
}

#endif // NAVIGATION_H
