DeltaGod/PER_MEA_LYINCROYAP/(commit log)

2026-04-29 Add navigation layer, mission system, and rewrite README
    - Navigator: haversine distance + bearing (namespace, no state)
    - MissionPlan: data struct — Waypoint[16], count, MissionMode (Linear/Circuit)
    - MissionManager: state machine Idle→Running→Returning→Complete with
    emergencyReturn(), setHome(), loadMission() designed for LoRa ingestion
    - Types.h: add Waypoint, MissionMode, MissionState enums
    - DroneApp: wire MissionManager into controlTick (Automatic mode) and
    debugTick (prints state, target, distance, bearing)
    - README.md: full rewrite covering hardware, pin map, architecture,
    control modes, mission system, serial output, build steps, status table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
2026-04-29 Improve GPS diagnostics: satellites in view, last NMEA line
    - GpsUart: add TinyGPSCustom field to parse total satellites in view
    from $GPGSV sentence (field 3), exposed via satsInView()
    - GpsUart: capture last complete NMEA sentence into a separate
    completedLine_ buffer (fixes multi-sentence concatenation bug)
    - DroneApp: NO FIX line now shows visible=N satellite count and
    last raw NMEA sentence for hardware diagnosis
    [DroneApp.cpp, GpsUart.cpp, GpsUart.h]
2026-05-06 Servo corrected but still not working
    [Calibration.h, McpwmActuators.cpp]
2026-05-06 Servo corrected. Pls work
    [McpwmActuators.cpp]
2026-05-20 Fix GPS NMEA silence, active antenna, rotor servo PWM, and servo model
    GPS: send UBX CFG-CFG factory reset on every boot to clear any saved flash
    config that disables NMEA output (symptom: chars frozen at 10 = one ACK
    frame). Follow with CFG-ANT to enable active antenna supervisor and DC bias
    for Taoglas ADFGP.25A — RF switch routes signal to external u.FL.
    Rotor servo: remove mcpwm_set_duty_type DUTY_MODE_1 call on MCPWM_OPR_B.
    Both sail and rotor use the same BC548 NPN level-shifter circuit; MODE_1
    was double-inverting the rotor signal into an unusable waveform. Both
    channels now use DUTY_MODE_0 (default, active-high).
    Regatta ECO II model correction: servo is positional multi-turn (PW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
    [Calibration.h, GpsUart.cpp, McpwmActuators.cpp]
2026-06-03 Commit de Essay
2026-06-03 Fixed range of the Safran and Better debug mode
    [AxpPower.cpp, BatteryAdc.cpp, BoardConfig.h, Calibration.h, DebugConfig.h, DroneApp.cpp, GpsUart.cpp]
2026-06-10 IHM: diagnóstico de viento, brújula, trayectoria, auto-detección USB; modo manual unificado
    Firmware:
    - Modo manual unificado (CH5: Auto / Sail inerte / Manual); CH3 propulsor inverso
    (1100µs=100%, 1990µs=0%, <10%→0%), sin arming. Enum Sail/Manual.
    - Heartbeat: campos fix/sat/hdop/rc + wobs (progreso medición viento, condicional);
    control_mode eliminado; recortes (heading entero, location 5 dec, waypoints→wt/wc).
    - Transceiver inyecta RSSI medido en tierra.
    IHM:
    - Panel de salud (Liaison/GPS/Batterie/RC/Contrôle) + RSSI + advertencia si se pierde el enlace.
    - Brújula de viento, predicción de trayectoria (nav.js = réplica de navigation.h + simulador),
    barra de progreso de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
    [BoardConfig.h, Calibration.h, DroneApp.cpp]
2026-06-17 Add IHM_desktop: standalone Python desktop ground station
    Modern CustomTkinter + tkintermapview replica of the web IHM (IHM/),
    running in a single process with no MongoDB/FastAPI/Docker/browser.
    Talks directly to the transceiver over USB.
    - ihm_desktop.py: dark-themed GUI (map, live telemetry, health
    semaphores, wind compass, wind-measurement bar, waypoints, GeoJSON
    import, trajectory prediction, all boat commands)
    - serial_link.py: direct serial link (CP2104 auto-detect, 3x burst
    send, DTR/RTS reset) replacing serial_link.py + config.py + Mongo bus
    - nav.py: 1:1 Python port of navigation.h / nav.js trajectory prediction
    The web IHM under IHM/ is left untouched.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
    [ihm_desktop.py, nav.py, serial_link.py]
2026-06-17 Firmware: propulsion ESC bidirectionnelle en mode manuel
    Manette CH3 à crans: centre = neutre (1500 µs, zone morte ±40 µs),
    vers le bas = +100 % avant, vers le haut = -100 % arrière. Neutre
    canonique (ESC_STOP_US = ESC_NEUTRAL_US = 1500) utilisé au boot,
    failsafe, mode Sail et arrêt auto. Borne basse du clamp ESC abaissée
    à ESC_REVERSE_MIN_US (1000). Seuils AUTO_ESC_* décalés dans la moitié
    avant (1600/1700/1850). Suppression de l'ancien throttle inverse
    0-100 % et de PROP_MIN_FRACTION.
    NB: la marche arrière exige l'ESC programmé en bidirectionnel (EPRG-3).
    Compile 28 % flash / 7 % RAM.
    [BoardConfig.h, Calibration.h, McpwmActuators.cpp, McpwmActuators.h, Types.h]
2026-06-17 Docs: AI_CONTEXT, rapports ES/FR et architecture
    Ajoute AI_CONTEXT.md (contexte projet complet), les rapports
    informe_proyecto_es / rapport_projet_fr (.tex + .pdf),
    Architecture_projet.txt, et met à jour CLAUDE.md (ESC bidirectionnel).
2026-06-17 Integrate Testautoboat boat simulation + updated navigation
    Brings the standalone navigation simulation written by the teammate on
    branch Testautoboat (DeltaGod/PER_MEA_LYINCROYAP), plus the newer
    navigation.h it targets. Selective integration — the rest of that branch
    (IHM-less, pre-June firmware) is intentionally NOT merged.
    - simulation/: self-contained C++ sim (g++/make, own Arduino/LoRa/SPI
    mocks). Only firmware dependency is navigation.h. Builds clean and runs
    all 7 scenarios; HTML export to simulation/output/.
    - navigation.h: rudder compensation by relative wind + split limits
    (NAV_RUDDER_CORRECTION_LIMIT_DEG=20, NAV_RUDDER_COMMAND_LIMIT_DEG=110).
    Public entry points unchan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
2026-06-17 AutoController: use navigation's full ±110° rudder range (no ±20° clamp)
    The autonomous rudder was artificially clamped to ±ROTOR_AUTO_RANGE_DEG=20°,
    which throttled the navigation command (now ±NAV_RUDDER_COMMAND_LIMIT_DEG=110°
    after the Testautoboat update). Auto now maps the full nav command 1:1 onto
    physical winch degrees, exactly like the simulation (sim_boat clamps rudder to
    ±110° as "the real servo range").
    - Calibration.h: drop ROTOR_AUTO_RANGE_DEG; add ROTOR_AUTO_MIN/MAX_US =
    1399/1601 µs (= 1500 ± 110°×0.92 µs/°), the autonomous winch envelope.
    - AutoController::rudderToUs: clamp to ±NAV_RUDDER_COMMAND_LIMIT_DEG and to the
    auto µs envelope, same 0.92 µs/° s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
